PeakeElectronicInnovation/Target-Control-System-v1.0/Src/Target_Control_System_v1.1/images/remote_pair_bg.png

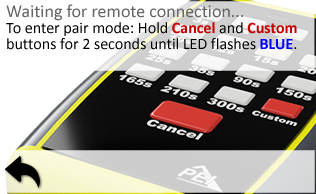
Src/Target_Control_System_v1.1/images/remote_pair_bg.png
