PeakeElectronicInnovation/Target-Control-System-v1.0/README.md

# Target-Control-System-v1.0
Solenoid actuated pneumatic target turn control system timer and wireless remote
