PeakeElectronicInnovation/Target-Control-System-v1.0/Electronics/Target Control Remote Schematic & PCB Design Files/Target Control Remote Schematic.pdf

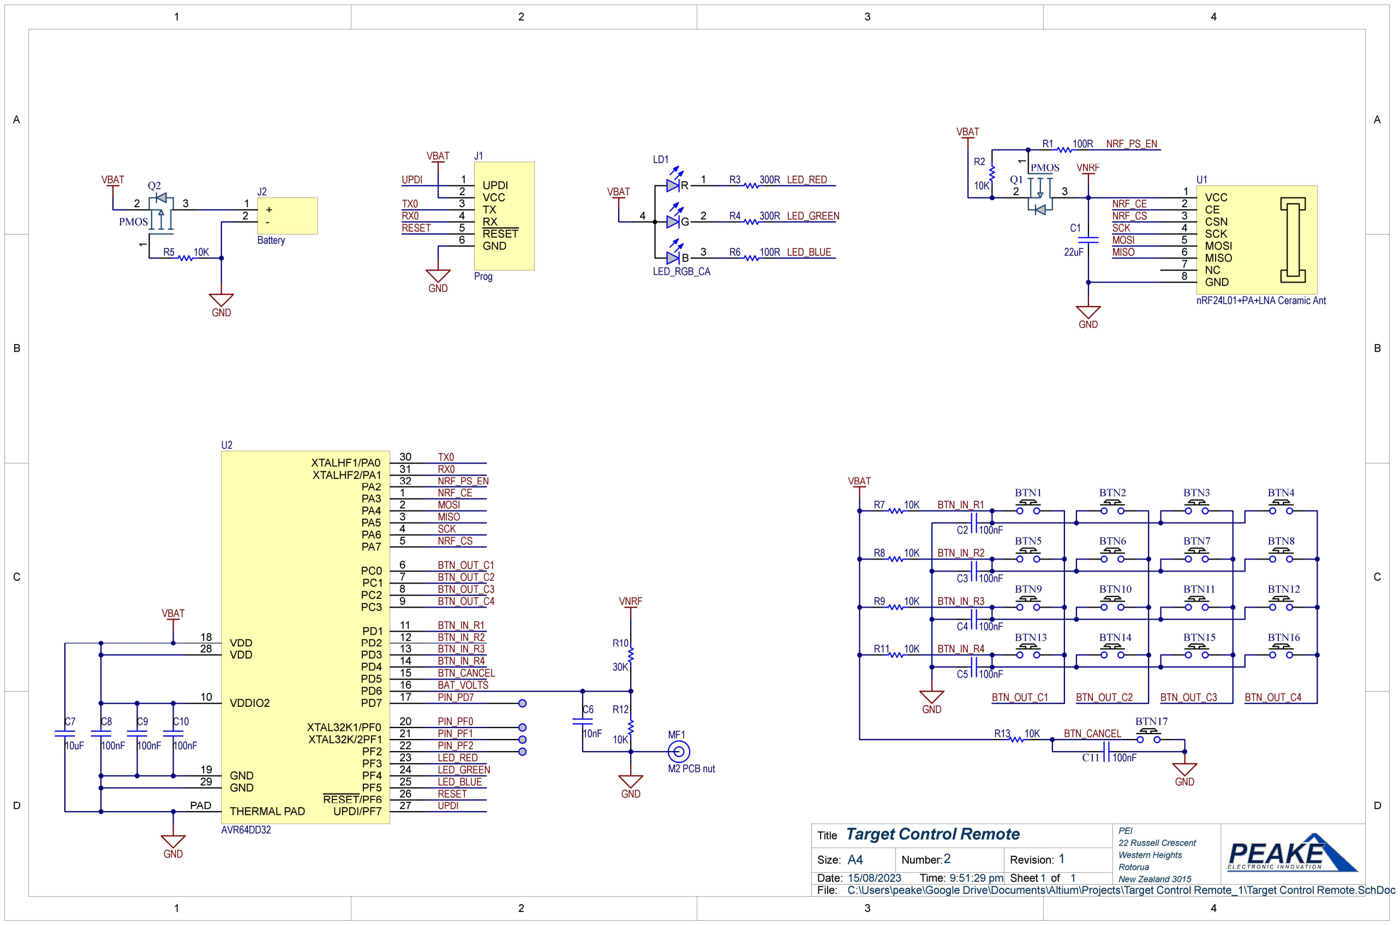
[picture p2: page 1]

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
### 22 Russell Crescent

Western Heights
Rotorua

### 1 New Zealand 3015

## Target Control Remote

2 1

15/08/2023 | 9:51:29 pm
C:\Users\peake\Google Drive\Documents\Altium\Projects\Target Control Remote_1\Target Control Remote.SchDoc

Title

Size: | Number:
Date:
File:

Revision:
Time: | Sheet of

A4

XTALHF1/PA0 | 30
XTALHF2/PA1 | 31
PA2 | 32
PA3 | 1
PA4 | 2
PA5 | 3
PA6 | 4
PA7 | 5
PC0 | 6
PC1 | 7
PC2 | 8
PC3 | 9

VDDIO2 10

PD1 | 11
PD2 | 12
PD3 | 13
PD4 | 14
PD5 | 15
PD6 | 16
PD7 | 17

VDD 18

GND 19

XTAL32K1/PF0 | 20
XTAL32K/2PF1 | 21
PF2 | 22
PF3 | 23
PF4 | 24
PF5 | 25
RESET/PF6 | 26
UPDI/PF7 | 27

VDD 28

GND 29

THERMAL PAD PAD

U2

AVR64DD32

100nF

C8

100nF

C9

100nF

C10

GND

VBAT

10uF

C7

MOSI
MISO
SCK
NRF_CS

NRF_CE

BTN_OUT_C1
BTN_OUT_C2
BTN_OUT_C3
BTN_OUT_C4

BTN_IN_R1
BTN_IN_R2
BTN_IN_R3
BTN_IN_R4
BTN_CANCEL

LED_RED
LED_GREEN
LED_BLUE
RESET
UPDI
BTN1 | BTN2 | BTN3 | BTN4
BTN5 | BTN6 | BTN7 | BTN8
BTN9 | BTN10 | BTN11 | BTN12
BTN13 | BTN14 | BTN15 | BTN16
R7 | 10K
R8 | 10K
R9 | 10K

R11 10K

C2 100nF

C3 100nF

C4 100nF

C5 100nF

GND

VBAT

BTN_IN_R1

BTN_IN_R2

BTN_IN_R3

BTN_IN_R4

BTN_OUT_C1 | BTN_OUT_C2 | BTN_OUT_C3 | BTN_OUT_C4
| | BTN17
R13 10K

GND

C11 100nF

BTN_CANCEL

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
LED_RGB_CA | 1
| 2 3

Q1

PMOS

VBAT

10K

R2

R1 100R NRF_PS_EN

GND

R3 | 300R
R4 | 300R
R6 | 100R

VBAT

LED_RED

LED_GREEN

LED_BLUE

+

1

2

J2

Battery

UPDI 1
VCC 2
TX 3
RX 4
RESET 5
GND 6

J1

Prog

GND

VBAT

GND

VBAT

UPDI

TX0

BAT_VOLTS
PIN_PD7

PIN_PF0
PIN_PF1
PIN_PF2

VCC 1
CE 2
CSN 3
SCK 4
MOSI 5
MISO 6
NC 7
GND 8

U1

nRF24L01+PA+LNA Ceramic Ant

NRF_CE
NRF_CS
SCK

MISO

MOSI

RESET

VNRF

30K

R10

10K

R12

GND

VNRF

RX0
NRF_PS_EN

TX0
RX0

22uF

C1

10nF

C6

MF1

M2 PCB nut

1

2 3

Q2

PMOS

R5 10K
