PeakeElectronicInnovation/Target-Control-System-v1.0/Electronics/Target Control System Schematic & PCB Design Files/ATSAMD51J Pinmux Table.xlsx

Arduino Setup/MCU Peripherals |  |  |  |  |  |  |  |  | Board Functions
Pin | Name | Arduino Pin | Analog | Serial Assignment | Sercom | Sercom Alt | TC | TCC | #define Name | Pin Function | Direction
1 | PA00 |  |  |  |  | 1[0] | 2[0] |  |  | Crystal oscilator | IN
2 | PA01 |  |  |  |  | 1[1] | 2[1] |  |  | Crystal oscilator | OUT
3 | PA02 | 14/37 | A0 |  |  |  |  |  | #define IN_CUSTOM | Custom time button | IN
4 | PA03 | 36 |  |  |  |  |  |  | #define IN_15 | 300s button | IN
13 | PA04 | 17 | A3 |  |  | 0[0] | 0[0] |  | #define IN_4 | 8s button | IN
14 | PA05 | 15/38 | A1 |  |  | 0[1] | 0[1] |  | #define IN_3 | 6s button | IN
15 | PA06 | 16 | A2 |  |  | 0[2] | 1[0] |  | #define IN_2 | 4s button | IN
16 | PA07 | 47 |  |  |  | 0[3] | 1[1] |  | #define IN_1 | 3s button | IN
17 | PA08 | 43 |  | SDA sercom0 | 0[0] | 2[1] | 0[0] | 0[0] |  | TFT touch I2C data | IO
18 | PA09 | 44 |  | SCL sercom0 | 0[1] | 2[0] | 0[1] | 0[1] |  | TFT touch I2C clock | OUT
19 | PA10 | 45 |  |  | 0[2] | 2[2] | 1[0] | 0[2] | #define TFT_RST | TFT reset | IN
20 | PA11 | 46 |  |  | 0[3] | 2[3] | 1[1] | 0[3] | #define TFT_T_IRQ | TFT touch interrupt | IN
29 | PA12 | 26 |  | MOSI sercom2 | 2[0] | 4[1] | 2[0] | 0[6] |  | TFT SPI data in | OUT
30 | PA13 | 25 |  | SCK sercom2 | 2[1] | 4[0] | 2[1] | 0[7] |  | TFT SPI clock | OUT
31 | PA14 | 24 |  | MISO sercom2 | 2[2] | 4[2] | 3[0] | 2[0] |  | TFT SPI data out | IN
32 | PA15 | 48 |  |  | 2[3] | 4[3] | 3[1] | 2[1] | #define TFT_DC | TFT Data/Command | OUT
35 | PA16 | 13/32/39 |  | SCK_1 sercom3 (alt) | 1[0] | 3[1] | 2[0] | 1[0] |  | Wireless SPI clock | OUT
36 | PA17 | 12/34 |  | MISO_1 sercom3 (alt) | 1[1] | 3[0] | 2[1] | 1[1] |  | Wireless SPI data out | IN
37 | PA18 | 10/35 |  |  | 1[2] | 3[2] | 3[0] | 1[2] | #define NRF_CE | Wireless chip enable | OUT
38 | PA19 | 11/33 |  | MOSI_1 sercom3(alt) | 1[3] | 3[3] | 3[1] | 1[3] |  | Wireless SPI data in | OUT
41 | PA20 | 9 |  |  | 5[2] | 3[2] | 7[0] | 1[4] | #define OUT_1 | Solenoid MOSFET 1 | OUT
42 | PA21 | 8 |  |  | 5[3] | 3[3] | 7[1] | 1[5] | #define OUT_2 | Solenoid MOSFET 2 | OUT
43 | PA22 | 1 |  | ~~TX sercom3~~ | 3[0] | 5[1] | 4[0] | 1[6] | #define OUT_3 | Solenoid MOSFET 3 | OUT
44 | PA23 | 0 |  | ~~RX sercom3~~ | 3[1] | 5[0] | 4[1] | 1[7] |  | GPIO D0 | IN/OUT
45 | PA24 | 30 |  |  | 3[2] | 5[2] | 5[0] | 1[2] |  | USB D- | IO
46 | PA25 | 31 |  |  | 3[3] | 5[3] | 5[1] |  |  | USB D+ | IO
51 | PA27 | 28 |  |  |  |  |  |  |  | GPIO D28 | IN/OUT
57 | PA30 |  |  |  |  | 1[2] | 6[0] | 2[0] |  | PDI clock | IN
58 | PA31 |  |  |  |  | 1[3] | 6[1] | 2[1] |  | PDI data | IN
61 | PB00 | 49 |  |  |  | 5[2] | 7[0] |  | #define IN_8 | 20s button | OUT
62 | PB01 | 50 |  |  |  | 5[3] | 7[1] |  | #define IN_7 | 15s button | IN
63 | PB02 | 20/22 | A6 | ~~SDA sercom5~~ |  | 5[0] | 6[0] | 2[2] | #define IN_6 | 12s button | IN
64 | PB03 | 21/23 | A7 | ~~SCL sercom5~~ |  | 5[1] | 6[1] |  | #define IN_5 | 10s button | IN
5 | PB04 | 51 |  |  |  |  |  |  | #define IN_14 | 210s button | IN
6 | PB05 | 52 |  |  |  |  |  |  | #define IN_13 | 165s button | IN
9 | PB06 | 27 |  |  |  |  |  |  | #define IN_12 | 150s button | IN
10 | PB07 | 29 |  |  |  |  |  |  | #define IN_11 | 90s button | IN
11 | PB08 | 18 | A4 |  |  | 4[0] | 4[0] |  | #define IN_10 | 35s button | IN
12 | PB09 | 19 | A5 |  |  | 4[1] | 4[1] |  | #define IN_9 | 25s button | IN
23 | PB10 | 41 |  |  |  | 4[2] | 5[0] | 0[4] | #define IN_START | Start button | IN
24 | PB11 | 42 |  |  |  | 4[3] | 5[1] | 0[5] | #define IN_CANCEL | Cancel button | IN
25 | PB12 | 7 |  |  | 4[0] |  | 4[0] | 3[0] |  | GPIO D7 | IN/OUT
26 | PB13 | 4 |  |  | 4[1] |  | 4[1] | 3[1] |  | GPIO D4 | IN/OUT
27 | PB14 | 5 |  |  | 4[2] |  | 5[0] | 4[0] | #define TFT_CS | TFT chip select | OUT
28 | PB15 | 6 |  |  | 4[3] |  | 5[1] | 4[1] | #define TFT_BL | TFT backlight PWM | OUT
39 | PB16 | 3 |  |  | 5[0] |  | 6[0] | 3[0] | #define NRF_CS | Wireless chip select | OUT
40 | PB17 | 2 |  |  | 5[1] |  | 6[1] | 3[1] | #define NRF_IRQ | Wireless interrupt | IN
49 | PB22 | 40 |  |  | 1[2] | 5[2] | 7[0] |  | #define LED_DAT | WS2812 LED data | OUT
50 | PB23 | 53 |  |  | 1[3] | 5[3] | 7[1] |  |  | GPIO D53 | IN/OUT
59 | PB30 | 54 |  |  |  | 5[1] | 0[0] | 4[0] |  | GPIO D54 | IN/OUT
60 | PB31 | 55 |  |  |  | 5[0] | 0[1] | 4[1] |  | GPIO D55 | IN/OUT
