PeakeElectronicInnovation/Target-Control-System-v1.0/3D models/Mains terminal cover.stl

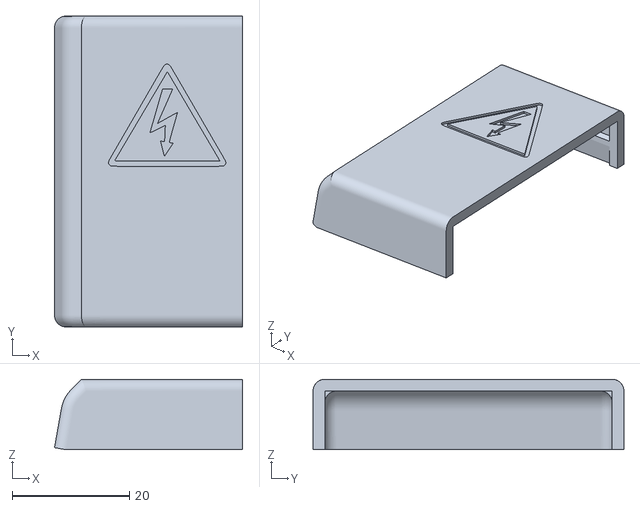
[picture p3: CAD file, 2023-08-15]
3D models/Mains terminal cover.stl
32.1 x 53.0 x 12.0
