PeakeElectronicInnovation/Target-Control-System-v1.0/3D models/LCD Bracket.stl

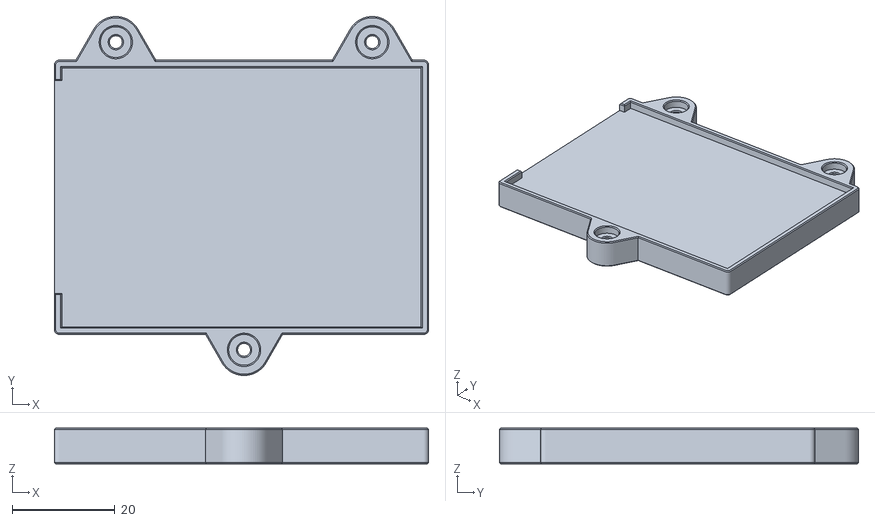
[picture p4: CAD file, 2023-08-18]
3D models/LCD Bracket.stl
73.0 x 70.0 x 7.00
