PeakeElectronicInnovation/Target-Control-System-v1.0/Electronics/Target Control System Schematic & PCB Design Files/Target Control System Front Panel.step

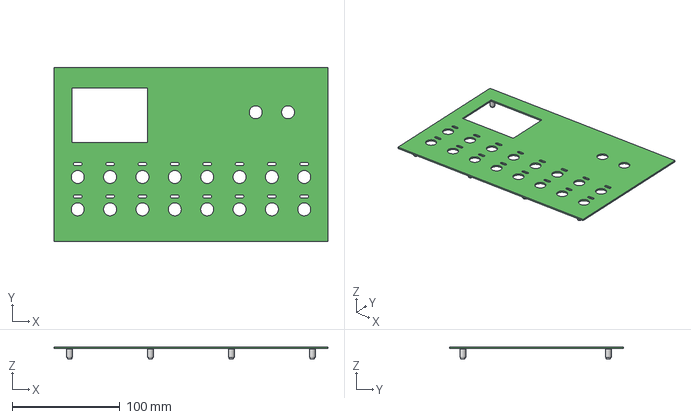
[picture p5: CAD file, 2023-08-15]
Electronics/Target Control System Schematic & PCB Design Files/Target Control System Front Panel.step
254.0 x 161.7 x 11.1 mm
PCB_Nut_M3x8mm x 8
