PeakeElectronicInnovation/Target-Control-System-v1.0/3D models/Timer button (LH cut).stl

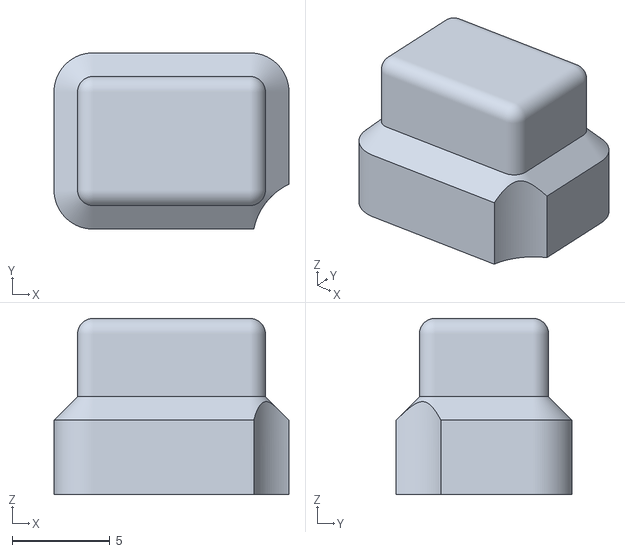
[picture p6: CAD file, 2023-08-15]
3D models/Timer button (LH cut).stl
12.0 x 9.00 x 9.00
