PeakeElectronicInnovation/Target-Control-System-v1.0/3D models/Wall bracket LH.stl

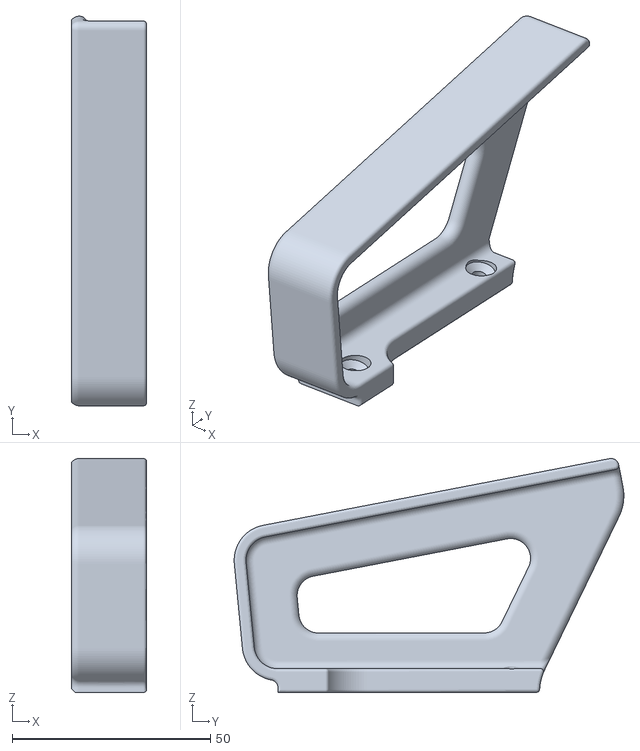
[picture p7: CAD file, 2023-08-15]
3D models/Wall bracket LH.stl
19.0 x 98.3 x 59.1
