PeakeElectronicInnovation/Target-Control-System-v1.0/3D models/P-clip.stl

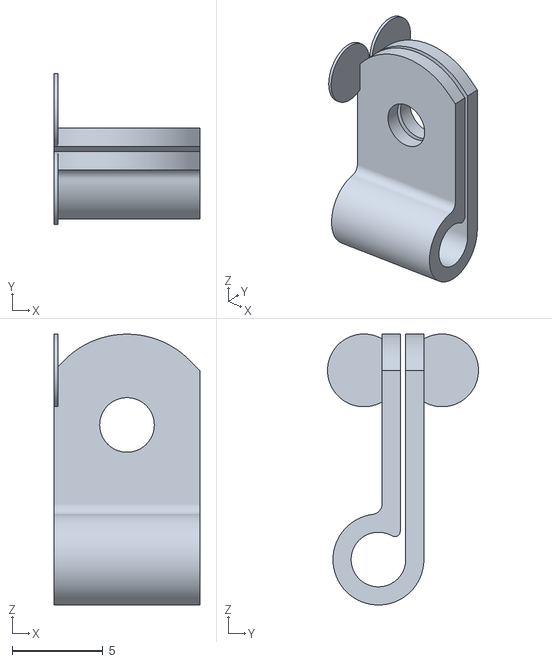
[picture p8: CAD file, 2023-08-15]
3D models/P-clip.stl
8.00 x 8.30 x 14.9
