PeakeElectronicInnovation/Target-Control-System-v1.0/3D models/Cancel button.stl

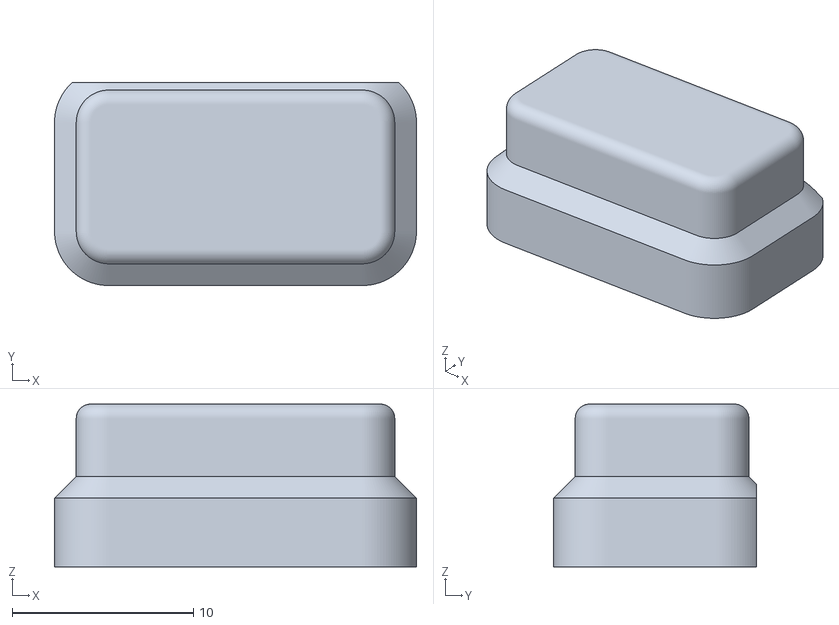
[picture p10: CAD file, 2023-08-15]
3D models/Cancel button.stl
20.0 x 11.2 x 9.00
