PeakeElectronicInnovation/Target-Control-System-v1.0/3D models/LED Diffuser x4.stl

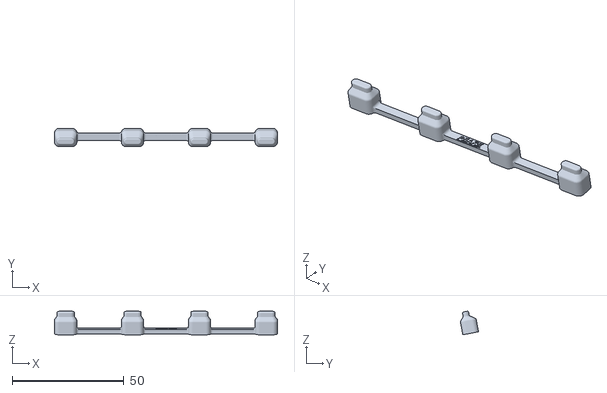
[picture p11: CAD file, 2023-08-15]
3D models/LED Diffuser x4.stl
100.0 x 8.15 x 10.6
