PeakeElectronicInnovation/Target-Control-System-v1.0/3D models/Batt support.stl

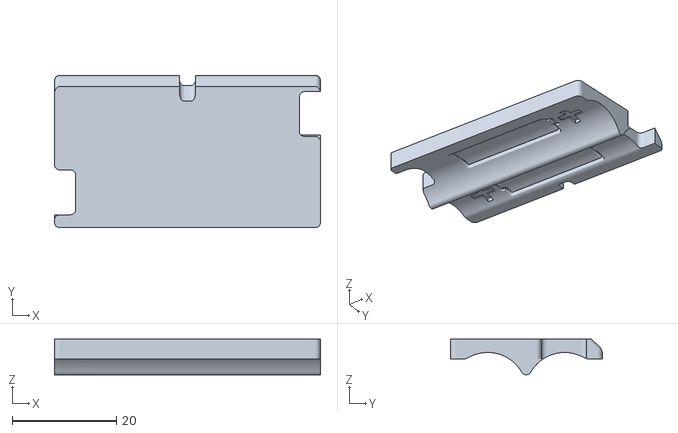
[picture p12: CAD file, 2023-08-15]
3D models/Batt support.stl
51.0 x 29.2 x 6.82
