PeakeElectronicInnovation/Target-Control-System-v1.0/3D models/Button matrix.stl

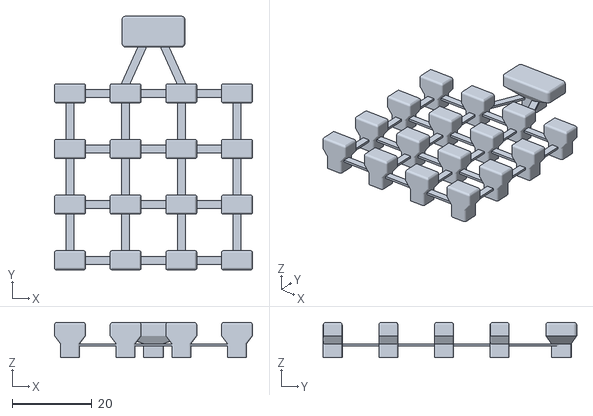
[picture p13: CAD file, 2023-08-15]
3D models/Button matrix.stl
49.8 x 63.8 x 8.90
