PeakeElectronicInnovation/Target-Control-System-v1.0/3D models/LED pipe.stl

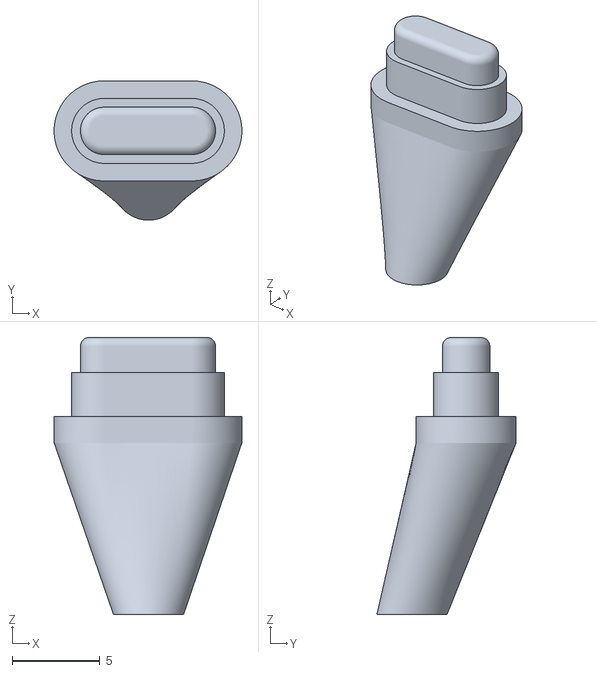
[picture p14: CAD file, 2023-08-15]
3D models/LED pipe.stl
10.7 x 7.94 x 15.8
