PeakeElectronicInnovation/Target-Control-System-v1.0/(list of files, cad)

Other CAD files:
3D models/Timer button (RH cut).stl
3D models/Wall bracket RH.stl
