PeakeElectronicInnovation/Target-Control-System-v1.0/(list of files, drawings)

Other design files:
Electronics/Target Control Remote Schematic & PCB Design Files/Target Control Remote Front Panel.PcbDoc
Electronics/Target Control Remote Schematic & PCB Design Files/Target Control Remote.PcbDoc
Electronics/Target Control Remote Schematic & PCB Design Files/Target Control Remote.PrjPcb
Electronics/Target Control Remote Schematic & PCB Design Files/Target Control Remote.SchDoc
Electronics/Target Control System Schematic & PCB Design Files/Target Control System Front Panel.PcbDoc
Electronics/Target Control System Schematic & PCB Design Files/Target Control System Front Panel.SchDoc
Electronics/Target Control System Schematic & PCB Design Files/Target Control System.PrjPcb
Electronics/Target Control System Schematic & PCB Design Files/Target Control System.SchDoc
