PeakeElectronicInnovation/Target-Control-System-v1.0/Src/Target_Control_System_v1.1/custom board/variant/tcs_m4/variant.h

/*
  Copyright (c) 2014-2015 Arduino LLC.  All right reserved.

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
  You should have received a copy of the GNU Lesser General Public
  License along with this library; if not, write to the Free Software
  Foundation, Inc., 51 Franklin St, Fifth Floor, Boston, MA  02110-1301  USA
*/

#ifndef _VARIANT_TCS_M4_
#define _VARIANT_TCS_M4_

// The definitions here needs a SAMD core >=1.6.10
#define ARDUINO_SAMD_VARIANT_COMPLIANCE 10610

/*----------------------------------------------------------------------------
 *        Definitions
 *----------------------------------------------------------------------------*/

/** Frequency of the board main oscillator */
#define VARIANT_MAINOSC		(32768ul)

/** Master clock frequency */
#define VARIANT_MCK	(F_CPU)

#define VARIANT_GCLK0_FREQ (F_CPU)
#define VARIANT_GCLK1_FREQ (48000000UL)
#define VARIANT_GCLK2_FREQ (100000000UL)

/*----------------------------------------------------------------------------
 *        Headers
 *----------------------------------------------------------------------------*/

#include "WVariant.h"

#ifdef __cplusplus
#include "SERCOM.h"
#include "Uart.h"
#endif // __cplusplus

#ifdef __cplusplus
extern "C"
{
#endif // __cplusplus

/*----------------------------------------------------------------------------
 *        Pins
 *----------------------------------------------------------------------------*/

// Number of pins defined in PinDescription array
#define PINS_COUNT           (35u)
#define NUM_DIGITAL_PINS     (29u)
#define NUM_ANALOG_INPUTS    (8u)
#define NUM_ANALOG_OUTPUTS   (2u)
#define analogInputToDigitalPin(p)  ((p < 6u) ? (p) + 14u : -1)

#define digitalPinToPort(P)        ( &(PORT->Group[g_APinDescription[P].ulPort]) )
#define digitalPinToBitMask(P)     ( 1 << g_APinDescription[P].ulPin )
//#define analogInPinToBit(P)        ( )
#define portOutputRegister(port)   ( &(port->OUT.reg) )
#define portInputRegister(port)    ( &(port->IN.reg) )
#define portModeRegister(port)     ( &(port->DIR.reg) )
#define digitalPinHasPWM(P)        ( g_APinDescription[P].ulPWMChannel != NOT_ON_PWM || g_APinDescription[P].ulTCChannel != NOT_ON_TIMER )

/*
 * digitalPinToTimer(..) is AVR-specific and is not defined for SAMD
 * architecture. If you need to check if a pin supports PWM you must
 * use digitalPinHasPWM(..).
 *
 * https://github.com/arduino/Arduino/issues/1833
 */
// #define digitalPinToTimer(P)

// LEDs
#define PIN_LED              6
#define LED_BUILTIN          PIN_LED
#define PIN_NEOPIXEL         (40)

/*
 * Analog pins
 */
#define PIN_A0               (14ul)
#define PIN_A1               (PIN_A0 + 1)
#define PIN_A2               (PIN_A0 + 2)
#define PIN_A3               (PIN_A0 + 3)
#define PIN_A4               (PIN_A0 + 4)
#define PIN_A5               (PIN_A0 + 5)
#define PIN_A6               (PIN_A0 + 6)
#define PIN_A7               (PIN_A0 + 7)
#define PIN_DAC0             PIN_A0
#define PIN_DAC1             PIN_A1

static const uint8_t A0  = PIN_A0;
static const uint8_t A1  = PIN_A1;
static const uint8_t A2  = PIN_A2;
static const uint8_t A3  = PIN_A3;
static const uint8_t A4  = PIN_A4;
static const uint8_t A5  = PIN_A5;
static const uint8_t A6  = PIN_A6 ;
static const uint8_t A7  = PIN_A7 ;

static const uint8_t DAC0 = PIN_DAC0;
static const uint8_t DAC1 = PIN_DAC1;

#define ADC_RESOLUTION		12

// Other pins
#define PIN_ATN              (39ul)
static const uint8_t ATN = PIN_ATN;

/*
 * Serial interfaces
 */

// Serial1
/*
#define PIN_SERIAL1_RX       (0ul)
#define PIN_SERIAL1_TX       (1ul)
#define PAD_SERIAL1_TX       (UART_TX_PAD_0)
#define PAD_SERIAL1_RX       (SERCOM_RX_PAD_1)
*/

/*
 * SPI Interfaces
 */
#define SPI_INTERFACES_COUNT 2

/*
//TFT SPI interface (SPI)
#define PIN_SPI_MISO         (24u)		//PA14
#define PIN_SPI_MOSI         (26u)		//PA12
#define PIN_SPI_SCK          (25u)		//PA13
#define PERIPH_SPI           sercom2
#define PAD_SPI_TX           SPI_PAD_0_SCK_1
#define PAD_SPI_RX           SERCOM_RX_PAD_2

static const uint8_t SS	  	= 5 ;	
static const uint8_t MOSI 	= PIN_SPI_MOSI ;
static const uint8_t MISO 	= PIN_SPI_MISO ;
static const uint8_t SCK  	= PIN_SPI_SCK ;

//NRF SPI interface (SPI1)
#define PIN_SPI1_MISO         (34u)		//PA17
#define PIN_SPI1_MOSI         (33u)		//PA19
#define PIN_SPI1_SCK          (32u)		//PA16
#define PERIPH_SPI1           sercom3
#define PAD_SPI1_TX           SPI_PAD_3_SCK_1
#define PAD_SPI1_RX           SERCOM_RX_PAD_0

static const uint8_t SS1	= 37 ;	
static const uint8_t MOSI1 	= PIN_SPI1_MOSI ;
static const uint8_t MISO1 	= PIN_SPI1_MISO ;
static const uint8_t SCK1 	= PIN_SPI1_SCK ;
*/

//NRF SPI interface (SPI)
#define PIN_SPI_MISO         (34u)		//PA17
#define PIN_SPI_MOSI         (33u)		//PA19
#define PIN_SPI_SCK          (32u)		//PA16
#define PERIPH_SPI           sercom3
#define PAD_SPI_TX           SPI_PAD_3_SCK_1
#define PAD_SPI_RX           SERCOM_RX_PAD_0

static const uint8_t SS	  	= 37 ;	
static const uint8_t MOSI 	= PIN_SPI_MOSI ;
static const uint8_t MISO 	= PIN_SPI_MISO ;
static const uint8_t SCK  	= PIN_SPI_SCK ;

//TFT SPI interface (SPI1)
#define PIN_SPI1_MISO         (24u)		//PA14
#define PIN_SPI1_MOSI         (26u)		//PA12
#define PIN_SPI1_SCK          (25u)		//PA13
#define PERIPH_SPI1           sercom2
#define PAD_SPI1_TX           SPI_PAD_0_SCK_1
#define PAD_SPI1_RX           SERCOM_RX_PAD_2

static const uint8_t SS1	= 5 ;	
static const uint8_t MOSI1 	= PIN_SPI1_MOSI ;
static const uint8_t MISO1 	= PIN_SPI1_MISO ;
static const uint8_t SCK1 	= PIN_SPI1_SCK ;

/*
 * Wire Interfaces
 */
#define WIRE_INTERFACES_COUNT 1

#define PIN_WIRE_SDA         (43u)
#define PIN_WIRE_SCL         (44u)
#define PERIPH_WIRE          sercom0
#define WIRE_IT_HANDLER      SERCOM0_Handler
#define WIRE_IT_HANDLER_0    SERCOM0_0_Handler
#define WIRE_IT_HANDLER_1    SERCOM0_1_Handler
#define WIRE_IT_HANDLER_2    SERCOM0_2_Handler
#define WIRE_IT_HANDLER_3    SERCOM0_3_Handler

static const uint8_t SDA = PIN_WIRE_SDA;
static const uint8_t SCL = PIN_WIRE_SCL;

/*
 * USB
 */
#define PIN_USB_HOST_ENABLE (29ul)
#define PIN_USB_DM          (30ul)
#define PIN_USB_DP          (31ul)

/*
 * I2S Interfaces
 
#define I2S_INTERFACES_COUNT 1

#define I2S_DEVICE          0
#define I2S_CLOCK_GENERATOR 3

#define PIN_I2S_SDO          (8u)
#define PIN_I2S_SDI          (1u)
#define PIN_I2S_SCK         (3u)
#define PIN_I2S_FS          (9u)
#define PIN_I2S_MCK			(2u)*/

//PCC Pins
#define PIN_PCC_DEN1    (PIN_SPI_MOSI)
#define PIN_PCC_DEN2    (PIN_SPI_SCK)
#define PIN_PCC_CLK     (PIN_SPI_MISO)
#define PIN_PCC_D0      (13u)
#define PIN_PCC_D1      (12u)
#define PIN_PCC_D2      (10u)
#define PIN_PCC_D3      (11u)
#define PIN_PCC_D4      (9u)
#define PIN_PCC_D5      (8u)
#define PIN_PCC_D6      (1u)
#define PIN_PCC_D7      (0u)
#define PIN_PCC_D8      (5u)
#define PIN_PCC_D9      (6u)

/*
#if !defined(VARIANT_QSPI_BAUD_DEFAULT)
  // TODO: meaningful value for this
  #define VARIANT_QSPI_BAUD_DEFAULT 5000000
#endif*/

#ifdef __cplusplus
}
#endif

/*----------------------------------------------------------------------------
 *        Arduino objects - C++ only
 *----------------------------------------------------------------------------*/

#ifdef __cplusplus

/*	=========================
 *	===== SERCOM DEFINITION
 *	=========================
*/
extern SERCOM sercom0;
extern SERCOM sercom1;
extern SERCOM sercom2;
extern SERCOM sercom3;
extern SERCOM sercom4;
extern SERCOM sercom5;

//extern Uart Serial1;

#endif

// These serial port names are intended to allow libraries and architecture-neutral
// sketches to automatically default to the correct port name for a particular type
// of use.  For example, a GPS module would normally connect to SERIAL_PORT_HARDWARE_OPEN,
// the first hardware serial port whose RX/TX pins are not dedicated to another use.
//
// SERIAL_PORT_MONITOR        Port which normally prints to the Arduino Serial Monitor
//
// SERIAL_PORT_USBVIRTUAL     Port which is USB virtual serial
//
// SERIAL_PORT_LINUXBRIDGE    Port which connects to a Linux system via Bridge library
//
// SERIAL_PORT_HARDWARE       Hardware serial port, physical RX & TX pins.
//
// SERIAL_PORT_HARDWARE_OPEN  Hardware serial ports which are open for use.  Their RX & TX
//                            pins are NOT connected to anything by default.
#define SERIAL_PORT_USBVIRTUAL      Serial
#define SERIAL_PORT_MONITOR         Serial
// Serial has no physical pins broken out, so it's not listed as HARDWARE port
/*#define SERIAL_PORT_HARDWARE        Serial1
#define SERIAL_PORT_HARDWARE_OPEN   Serial1*/

#endif /* _VARIANT_HMI_M4_ */
