PeakeElectronicInnovation/Target-Control-System-v1.0/(commit log)

2023-08-15 Initial commit of version 1 files for TCS and TCR
    [Batt support.stl, Button matrix.stl, Cancel button.stl, LCD Bracket.stl, LED Diffuser x4.stl, LED pipe.stl, Mains terminal cover.stl, P-clip.stl]
2023-08-16 Bug fix Tx and Rx
    Fixed a bug which causes the Rx to ignore consecutive packets when they are identical (ie, multiple runs of the same timer setting). Added a packet ID field to the data packet which increments on every button push so that consecutive packets are never identical.
    [Target_Control_Remote_v1.2.ino, defines.h, selfdata.c, update-bootloader-tcs_m4-v3.14.0-10-gb17ca18.ino, variant.cpp]
2023-08-18 Redraw due to some weird angles in original
    [LCD Bracket.stl]
2023-09-01 Added a version with inverted outputs
    [Target_Control_System_v1.1_Inverted_Output.ino, defines.h]
